gsekn/Lidar-trigger/lidar v5 11-28-2024_schematic.pdf

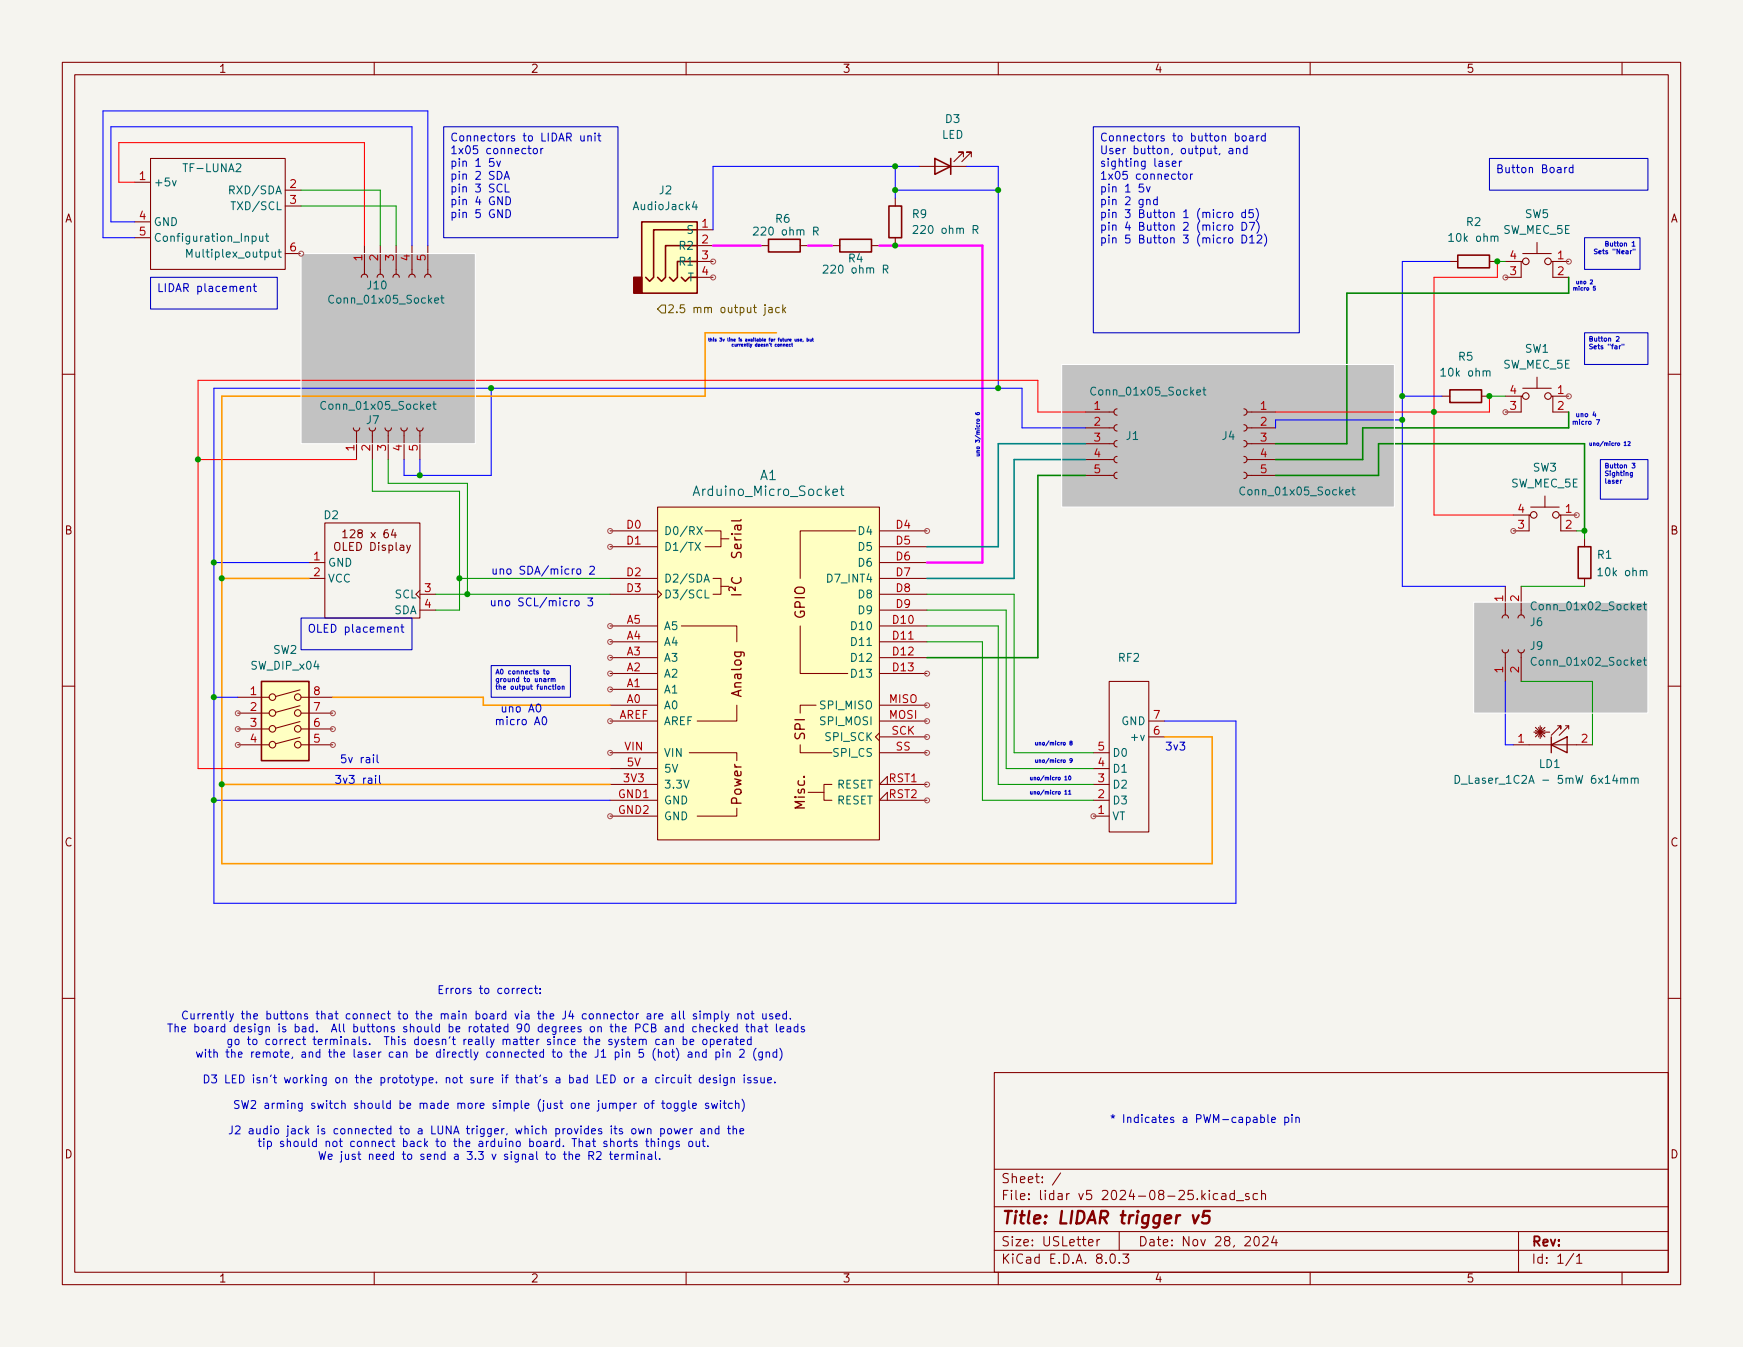
[picture p1: page 1]
