gsekn/Lidar-trigger/lidar v5 11-28-2024_pcb.pdf

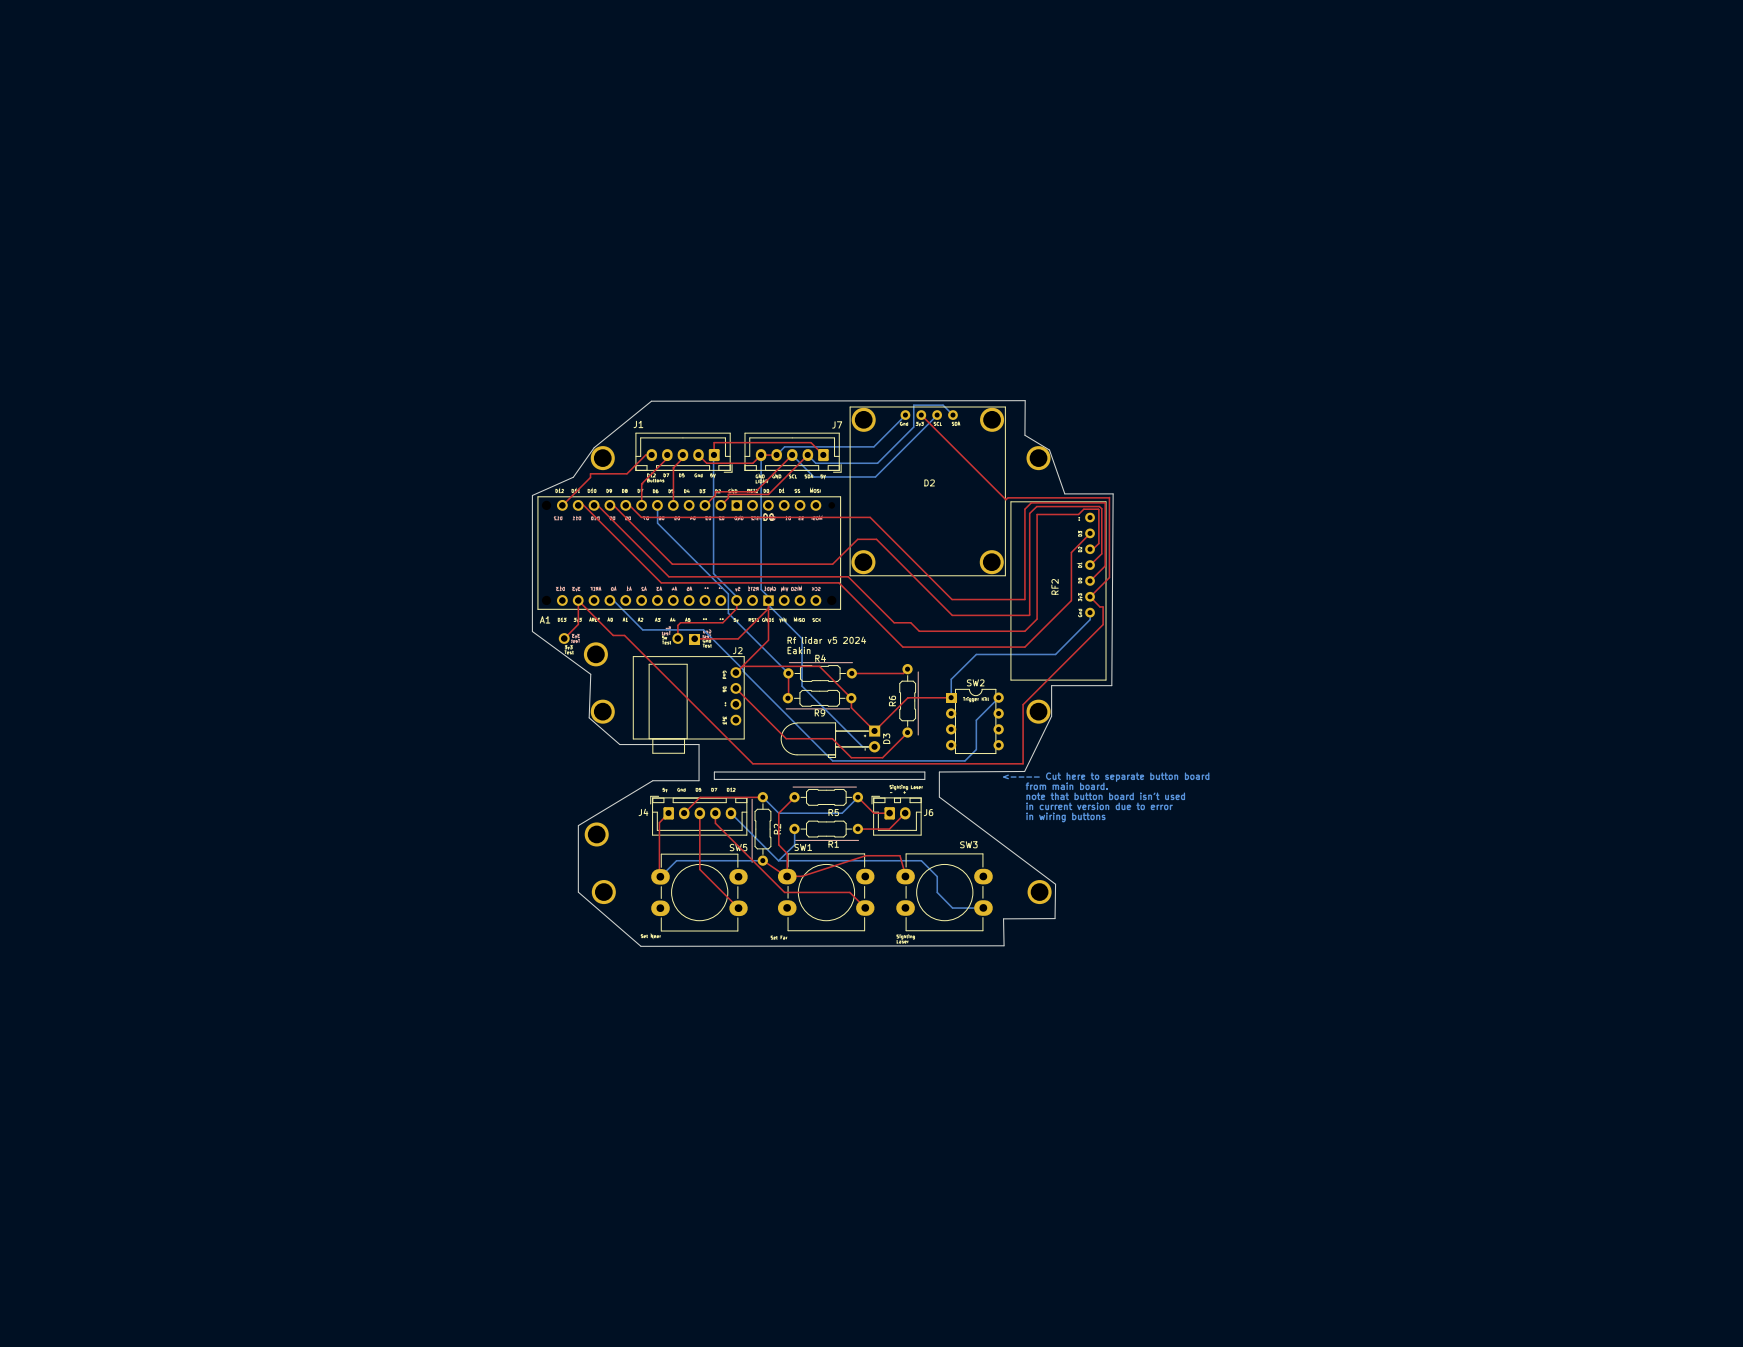
[picture p2: page 1]
